gabebuckmaster/PARmeter/hardware/PARmeter.kicad_pcb

## KiCad design hardware/PARmeter.kicad_pcb (2020-01-22)

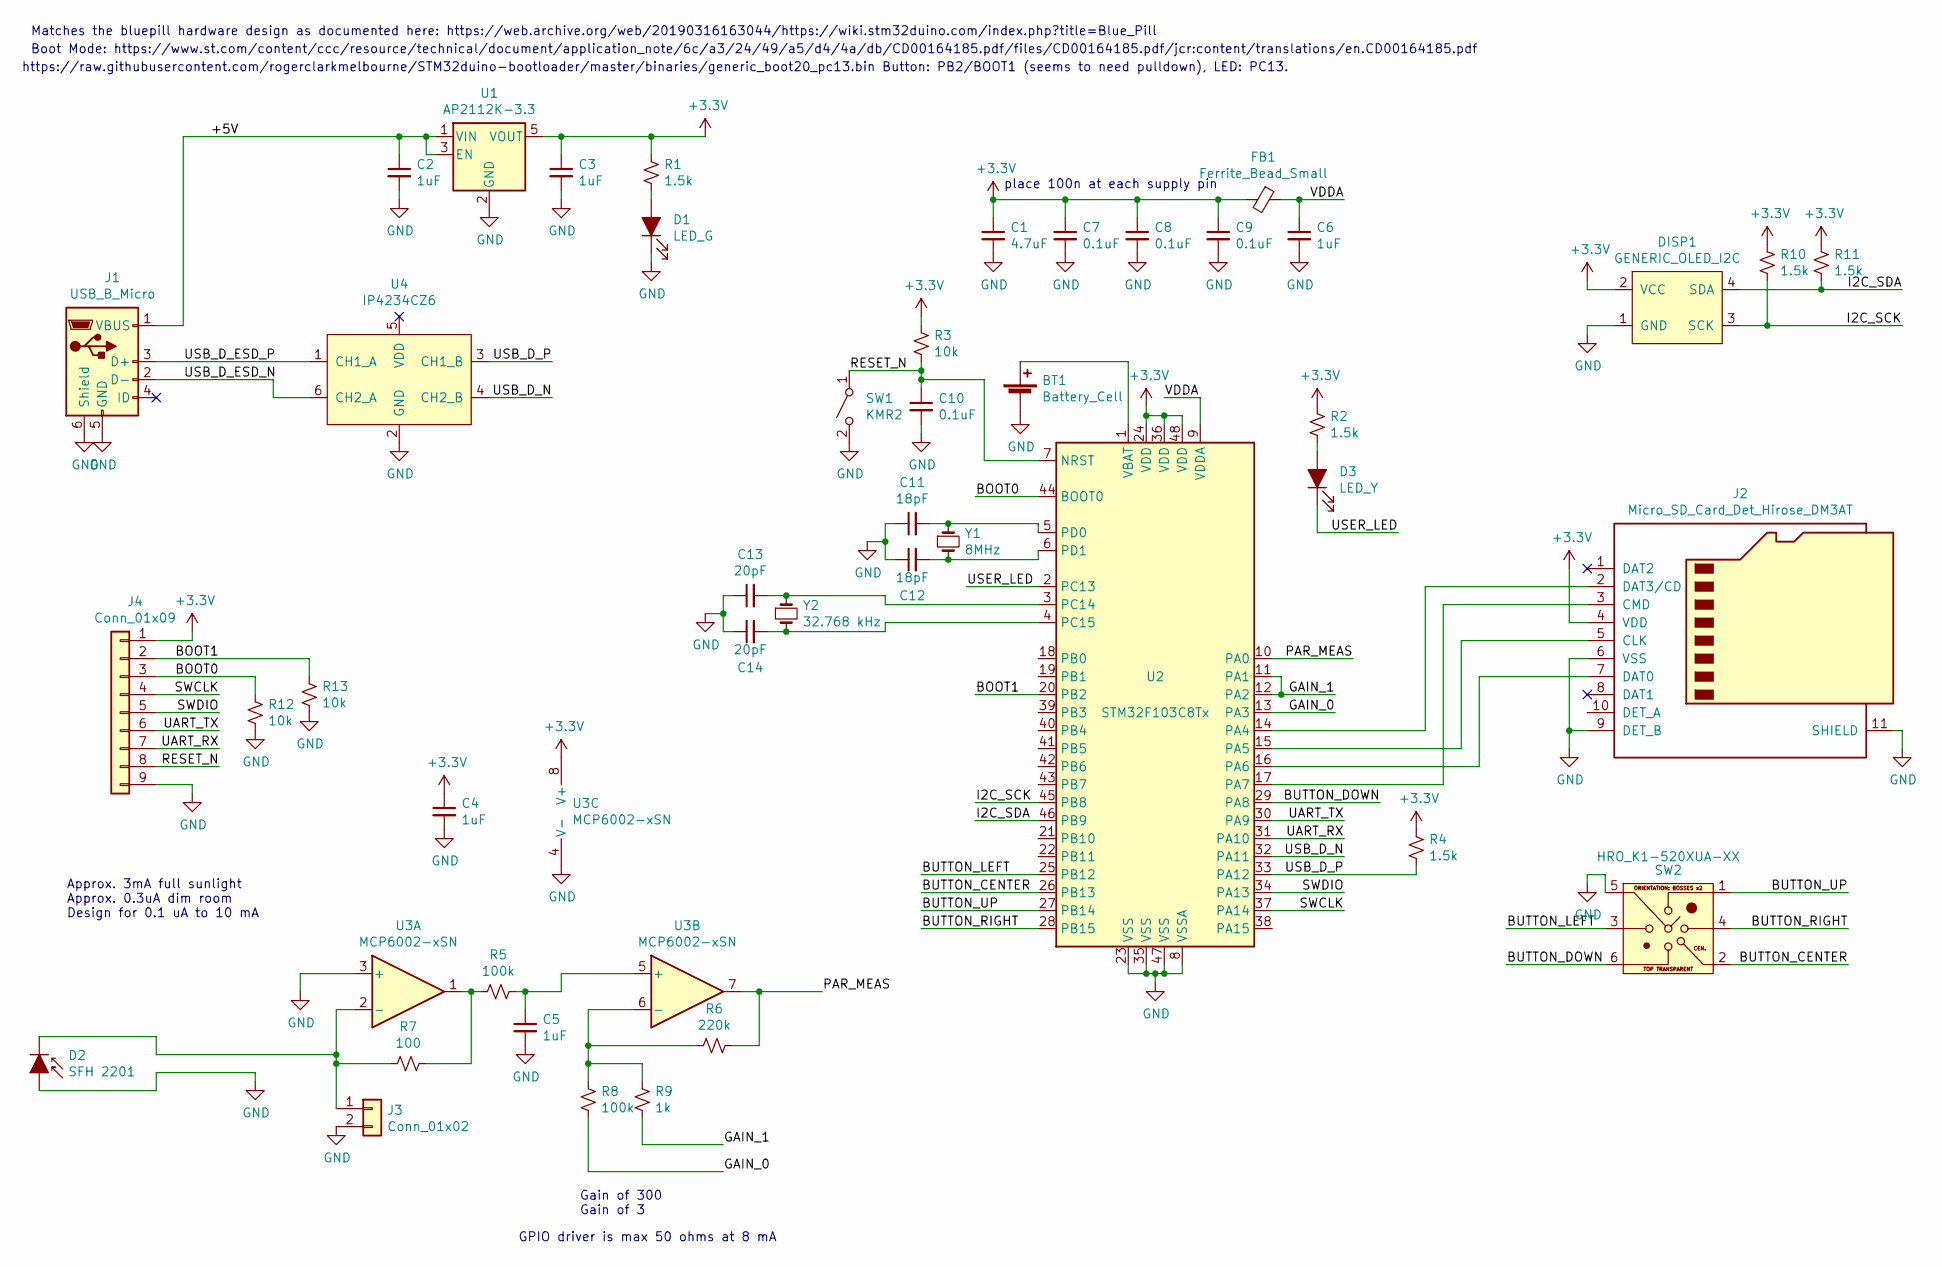
[picture p1: schematic PARmeter.sch]

Parts:
BT1: Battery_Cell; BatteryHolder_Keystone_3000_1x12mm
C1: 4.7uF; C_0805_2012Metric
C2, C3, C4, C5, C6: 1uF; C_0805_2012Metric
C7, C8, C9, C10: 0.1uF; C_0805_2012Metric
C11, C12: 18pF; C_0805_2012Metric
C13, C14: 20pF; C_0805_2012Metric
D1: LED_G; LED_0805_2012Metric
D2: SFH 2201; OSRAM_SFH2201
D3: LED_Y; LED_0805_2012Metric
DISP1: GENERIC_OLED_I2C; Generic_OLED_Display_0.96
FB1: Ferrite_Bead_Small; LED_0805_2012Metric
J1: USB_B_Micro; USB_Micro-B_Amphenol_10118194-0001LF_Horizontal
J2: Micro_SD_Card_Det_Hirose_DM3AT; microSD_HC_Hirose_DM3AT-SF-PEJM5
J3: Conn_01x02; PinHeader_1x02_P2.54mm_Vertical
J4: Conn_01x09; PinHeader_1x09_P2.54mm_Vertical
R1, R2, R4, R10, R11: 1.5k; R_0805_2012Metric
R3, R12, R13: 10k; R_0805_2012Metric
R5, R8: 100k; R_0805_2012Metric
R6: 220k; R_0805_2012Metric
R7: 100; R_0805_2012Metric
R9: 1k; R_0805_2012Metric
SW1: KMR2; SW_Push_1P1T_NO_CK_KMR2
SW2: HRO_K1-520XUA-XX
U1: AP2112K-3.3; SOT-23-5
U2: STM32F103C8Tx; LQFP-48_7x7mm_P0.5mm
U3: MCP6002-xSN; SOIC-8_3.9x4.9mm_P1.27mm
U4: IP4234CZ6; TSOP-6_1.65x3.05mm_P0.95mm
Y1: 8MHz; Crystal_SMD_5032-2Pin_5.0x3.2mm
Y2: 32.768 kHz; Crystal_SMD_3215-2Pin_3.2x1.5mm

Connections:
+3V3: C1.1, C3.1, C4.1, C7.1, C8.1, C9.1, DISP1.2 (VCC), FB1.2, J2.4 (VDD), J4.1, R1.1, R2.1, R3.1, R4.2, R10.2, R11.2, U1.5 (VOUT), U2.24 (VDD), U2.36 (VDD), U2.48 (VDD), U3.8 (V+)
/+5V: C2.1, J1.1 (VBUS), U1.1 (VIN), U1.3 (EN)
/BOOT0: J4.3, R12.1, U2.44 (BOOT0)
/BOOT1: J4.2, R13.1, U2.20 (PB2)
/BUTTON_CENTER: SW2.2, U2.26 (PB13)
/BUTTON_DOWN: SW2.6, U2.29 (PA8)
/BUTTON_LEFT: SW2.3, U2.25 (PB12)
/BUTTON_RIGHT: SW2.4, U2.28 (PB15)
/BUTTON_UP: SW2.1, U2.27 (PB14)
/GAIN_0: R8.2, U2.13 (PA3)
/GAIN_1: R9.2, U2.11 (PA1), U2.12 (PA2)
/I2C_SCK: DISP1.3 (SCK), R10.1, U2.45 (PB8)
/I2C_SDA: DISP1.4 (SDA), R11.1, U2.46 (PB9)
/PAR_MEAS: R6.1, U2.10 (PA0), U3.7
/RESET_N: C10.1, J4.8, R3.2, SW1.1 (A), U2.7 (NRST)
/SWCLK: J4.4, U2.37 (PA14)
/SWDIO: J4.5, U2.34 (PA13)
/UART_RX: J4.7, U2.31 (PA10)
/UART_TX: J4.6, U2.30 (PA9)
/USB_D_ESD_N: J1.2 (D-), U4.6 (CH2_A)
/USB_D_ESD_P: J1.3 (D+), U4.1 (CH1_A)
/USB_D_N: U2.32 (PA11), U4.4 (CH2_B)
/USB_D_P: R4.1, U2.33 (PA12), U4.3 (CH1_B)
/USER_LED: D3.1 (K), U2.2 (PC13)
/VDDA: C6.1, FB1.1, U2.9 (VDDA)
GND: BT1.2 (-), C1.2, C2.2, C3.2, C4.2, C5.2, C6.2, C7.2, C8.2, C9.2, C10.2, C11.1, C12.1, C13.1, C14.1, D1.1 (K), D2.2 (A), DISP1.1 (GND), J1.5 (GND), J1.6 (Shield), J2.6 (VSS), J2.9 (DET_B), J2.11 (SHIELD), J3.2, J4.9, R12.2, R13.2, SW1.2 (B), SW2.5, U1.2 (GND), U2.8 (VSSA), U2.23 (VSS), U2.35 (VSS), U2.47 (VSS), U3.3 (+), U3.4 (V-), U4.2 (GND)
unnamed: BT1.1 (+), U2.1 (VBAT)
unnamed: C5.1, R5.1, U3.5 (+)
unnamed: C11.2, U2.5 (PD0), Y1.1
unnamed: C12.2, U2.6 (PD1), Y1.2
unnamed: C13.2, U2.3 (PC14), Y2.1
unnamed: C14.2, U2.4 (PC15), Y2.2
unnamed: D1.2 (A), R1.2
unnamed: D2.1 (K), J3.1, R7.2, U3.2 (-)
unnamed: D3.2 (A), R2.2
unnamed: J2.2 (DAT3/CD), U2.14 (PA4)
unnamed: J2.3 (CMD), U2.17 (PA7)
unnamed: J2.5 (CLK), U2.15 (PA5)
unnamed: J2.7 (DAT0), U2.16 (PA6)
unnamed: R5.2, R7.1, U3.1
unnamed: R6.2, R8.1, R9.1, U3.6 (-)

Notes on the sheet:
Matches the bluepill hardware design as documented here: https://web.archive.org/web/20190316163044/https://wiki.stm32duino.com/index.php?title=Blue_Pill
Approx. 3mA full sunlight Approx. 0.3uA dim room Design for 0.1 uA to 10 mA
Gain of 300 Gain of 3
GPIO driver is max 50 ohms at 8 mA
place 100n at each supply pin
Boot Mode: https://www.st.com/content/ccc/resource/technical/document/application_note/6c/a3/24/49/a5/d4/4a/db/CD00164185.pdf/files/CD00164185.pdf/jcr:content/translations/en.C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
https://raw.githubusercontent.com/rogerclarkmelbourne/STM32duino-bootloader/master/binaries/generic_boot20_pc13.bin Button: PB2/BOOT1 (seems to need pulldown), LED: PC13.

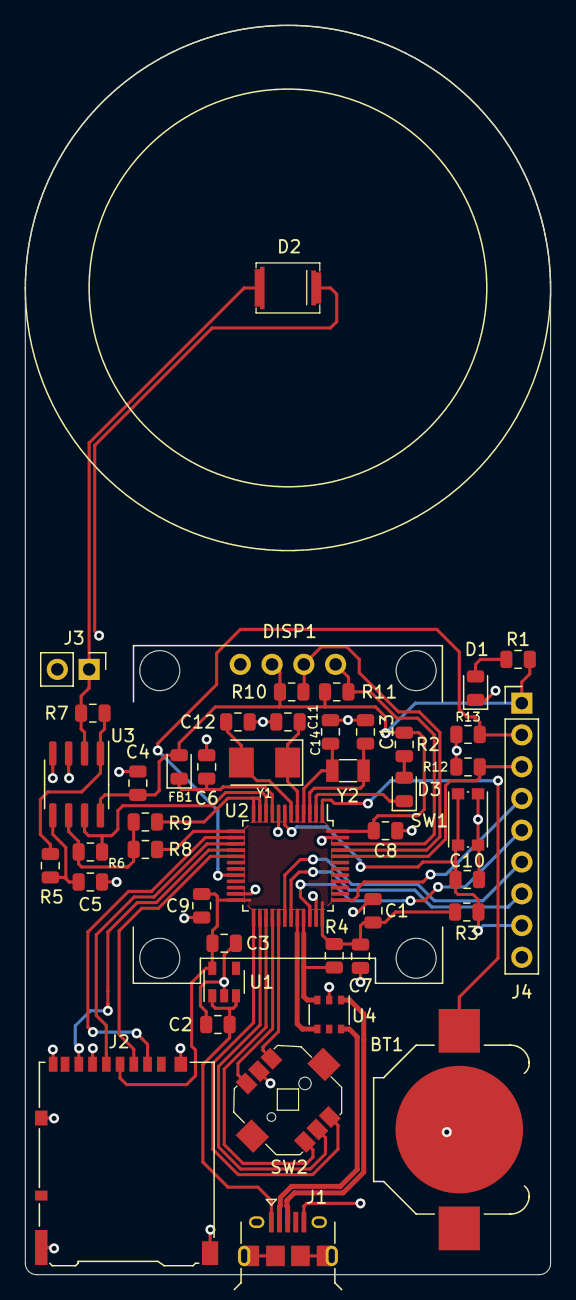
[picture p2: board PARmeter.kicad_pcb from above]

Board: 2 copper layers, 42.0 x 99.9 mm, 45 parts (0 on the bottom side), 41 nets.
