gabebuckmaster/PARmeter/(commit log)

2020-01-22 Initial commit
    Hardware design only for now
    [PARmeter-B_Cu.gbr, PARmeter-B_Mask.gbr, PARmeter-B_SilkS.gbr, PARmeter-Edge_Cuts.gbr, PARmeter-F_Cu.gbr, PARmeter-F_Mask.gbr, PARmeter-F_Paste.gbr, PARmeter-F_SilkS.gbr]
2020-01-23 fixed gain values + explicitly set gain outputs
    - Math is hard
    - Shouldn’t be necessary, but doesn’t hurt.
    [PARmeter.sch]
2020-01-23 Ditched dual-gain mode
    There is a problem where the GPIO LOW state pulls to ~3.5mV rather than
    0V as expected due to [supply current] * [resistance between the IC
    ground and PCB ground]. Using superposition, this ~3.5 mV sees an
    inverting amplifier with gain -Rf/Rs and causes an offset in the
    measured value, unfortunately limiting our low-end sensitivity. I
    mitigated this by increasing the transimpedance gain and reducing the
    voltage gain. With some averaging, we get clean measurements in the
    range of interest.
    [PARmeter.sch]
2020-01-23 Disabled center button causing offset calibration by default
    Eventually, would like a real UI for doing calibration (and save the
    values to non-volatile memory). Could be confusing as it was.
2020-01-23 Uncommented center-button offset code
    Turns out the offset varies noticeably between boards.
2020-01-29 Tested micro SD card, confirmed working
    See title
    [PARmeter.sch]
